RHash67/fbii-xl2t/arduino/README.md

## FBII XL-2T Interface - Arduino sketch

The Keypad_Interface.ino sketch is for the arduino alarm interface/connection as shown in the circuit diagram in this repository.

Serial communication with the Raspberry Pi is very simple.  A 1-byte character is sent from the RPi for an interface request.  ASCII characters 48 through 63 correspond to keypress signals.  ASCII character 64 causes the arduino to retrieve the 2-byte alarm status data packet and send it back to the RPi as a 5-byte string representation of the packet int value (parsing of the data packet to get the individual LED display status is done in the RPi since this only requires 5 bytes of data to be sent serially, rather than 12 bytes).

The libraries for this sketch can be found in the libraries folder in this repository.

The Interface_simulation.ino sketch will allow you to test the Raspberry Pi web interface and arduino serial communication without having to connect the actual alarm system.  The arduino sends preset alarm status values to the RPi, and indicates keypresses via the onboard LED.  The sketch includes a simulated alarm event for 10 seconds - this is useful for testing your email alarm notification.  My family was getting tired of my messing around with the alarm system, and the keypad buzzer constantly sounding during my web interface testing, so I came up with this sketch.
