RHash67/fbii-xl2t/_library/examples/README.md

Example Arduino sketches which uses the XL2T library.
