RHash67/fbii-xl2t/_pics/XL-2T Keypad closed r1.jpg

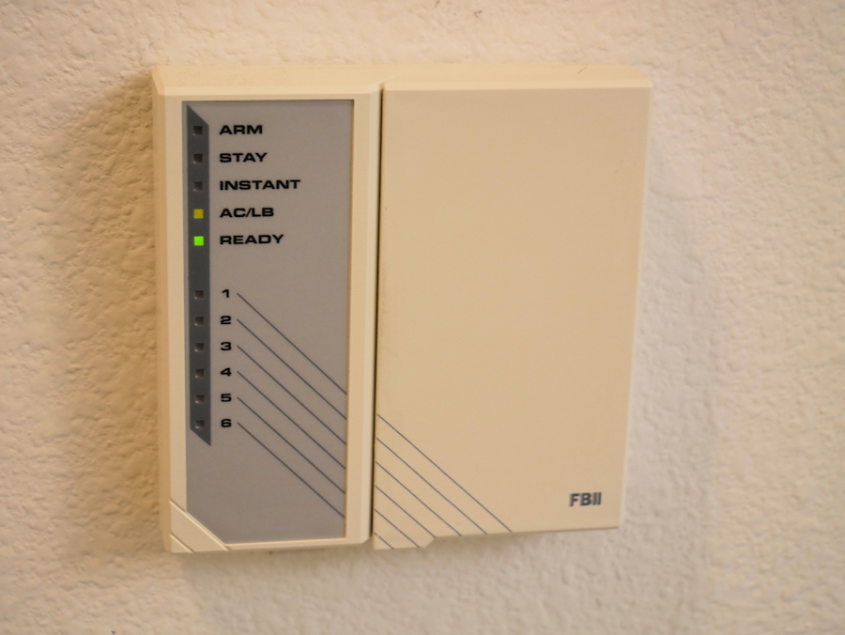
_pics/XL-2T Keypad closed r1.jpg
