RHash67/fbii-xl2t/data_signal_info/Oscope trace unarmed_ready.jpg

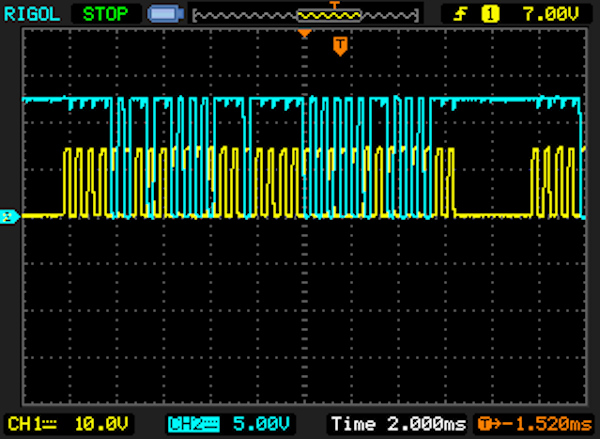
data_signal_info/Oscope trace unarmed_ready.jpg
