RHash67/fbii-xl2t/_testcode/README.md

Arduino test sketches for displaying alarm and keypad data values
