RHash67/fbii-xl2t/(threads)

Thread 3 (2023-07-03):

Driving the keypad from the uC

rooprob, 2023-07-03:
First, thanks for this.  I have a FBII STAR XL4500 and XL4500RM keypad.  My uC is an ESP8266.

The circuit is on a breadboard and I have the 12v reduced to 3.3v for the ESP. Arduino compiled the code, and I've made some small tweaks but it's basically working as-is. Nice!

I can read the status and LEDs with this project, but sendKey is not.
No errors and I see a little signal on Q3.

This is where my understanding breaks down.

How does the signal get put back to the yellow data line from the uC?

I'm trying to work out the purpose of R8.

I don't understand the Shunt. I'm trying to understand how writing to Shunt can put a 12v signal on Data line.

I'm only getting 3.3v out of the

I'll need to get more detailed testing.

Thanks for any pointers!
Good job on the code! I guess there are now two people adding WiFi to their 20yo alarms.

RHash67, 2023-07-07:
The keypress data is sent to the system by controlling the level of the data line during the low clock pulses.  If the shunt control is switched to its low level, then Q3 will be off, and the data line will remain high.  If the shunt control is switched high, then Q3 will turn on, and the data line will be forced to ground level (low).  The keypress signal is not “put onto” the data line – rather, the data line is just kept high or sent low (during the low clock pulses) to “send” the data.

R8 is there mostly for circuit stability.  If the shunt control level is floating for any reason (e.g. during circuit startup, or gets disconnected), R8 will ensure that Q3 is off, so it doesn’t affect the value of the data line during the read portion of the clock signal.

For my system I need to use transistors to interface the clock, data, and shunt because my alarm panel (FBII XL-2T) has the clock and data at +12V - +15V range.  If I try to connect those directly to my uC I will burn it out.  I’m not familiar with your FBII SA4500 system, but if your clock and data signals are at 3.3V levels, then you might be able to monitor/control them via direct connection to your uC without using transistors.  If you do this you will need to modify the code to invert the logic levels, since the transistors invert the logic levels between their base and collector.  In the XL2T_Interface.cpp code, the _pulselvl and _signallvl variables are used to read the logic level of the signals.  If you read the signals directly, then you will need to modify the conditional tests (e.g. instead of testing == 0, would need to test == 1), and possibly modify code sections which invert the bits.

When I started this project I could not determine if the data stream followed any standardized format (e.g. RS-232, etc, which it does not).  Luckily the clock pulse period is rather long (0.5 ms), so I could easily capture the pulses with my digital oscope to reverse-engineer the signals.  Also, the clock pulses are slow enough where the code just relies on looking for the rising/falling edges of the clock, and counting the pulses.  I know this is not very sophisticated, but hey – it works!  😊

Good luck on your system interface!  I'm glad that someone has found this useful!

RHash67, 2023-07-07:
Also, keep in mind that a minimum of 2 identical keypress data needs to be sent in adjacent data packets to be considered a valid keypress.  The arduino code handles this via a simple loop for the keypress routine.

rooprob, 2023-07-24:
Thanks @RHash67

Thanks for your reply.   I can see how the shunt circuit works now, and I'm pleased to say it's all working well for me now.

Turns out the XL2T and the SA4500 are pretty much the same electrically and signalling. I get pretty much identical Alarm Status codes as you do.  My keypad does have different keycodes, and following your idea they are scattered around in the uint32_t as an obscurity, I have now successfully decoded, and I can send them back into the alarm to Arm it.

I had to make a few adjustments on this journey.
* read the keycode along with the alarm status during the readAllStatus()
* add the helper functions to read the alarm status bits from status value, rather than re-probing for them
* added a microsecond sleeps to try and put the bit-reading code directly in the middle of the 250us clock signal - the issue I had was I was reading the trailing edge and getting a lot of  jitter - maybe my Arduino is a bit faster or my wiring a bit noisy.

This clunky old alarm gets a useful IoT modernization. It will be taking up residence in the workshed.

Can consider this issue closed :)

RHash67, 2023-07-25:
Glad you were able to get your interface working!

It didn't occur to me that different FBII systems could have different keycode values.  Somewhere in my files I have a test sketch to display the keycode hex values on an LCD screen hooked up to the arduino - I should post them here (hopefully I've kept it somewhere).  I forgot I had used this as a "digital oscope" to capture the signal values.  I do have a "real" oscope, but it's not sophisticated enough to record waveforms on trigger events.  The test sketch I made was very handy in displaying the hex values associated with each keypress.

I'm happy to see at least one other clunky old alarm meeting the modern world!  :D

Closed 2023-07-24.

Thread 4 (2025-05-01):

gunicorn is not starting

stavreas, 2025-05-01:
× gunicorn.service - gunicorn daemon for /var/www/html/XL2T.py
     Loaded: loaded (/etc/systemd/system/gunicorn.service; enabled; preset: enabled)
     Active: failed (Result: exit-code) since Thu 2025-05-01 16:54:48 BST; 7s ago
   Duration: 47ms
    Process: 8532 ExecStart=/usr/local/bin/gunicorn --bind=unix:/tmp/gunicorn.sock -k geventwebsocket.gunicorn.workers.GeventWebSocketWorker --workers=1 XL2T:app (code=exited, status=203/EXEC)
   Main PID: 8532 (code=exited, status=203/EXEC)
        CPU: 12ms

May 01 16:54:48 raspberry-FBII systemd[1]: Started gunicorn.service - gunicorn daemon for /var/www/html/XL2T.py.
May 01 16:54:48 raspberry-FBII (gunicorn)[8532]: gunicorn.service: Failed to locate executable /usr/local/bin/gunicorn: No such file or directory
May 01 16:54:48 raspberry-FBII (gunicorn)[8532]: gunicorn.service: Failed at step EXEC spawning /usr/local/bin/gunicorn: No such file or directory
May 01 16:54:48 raspberry-FBII systemd[1]: gunicorn.service: Main process exited, code=exited, status=203/EXEC
May 01 16:54:48 raspberry-FBII systemd[1]: gunicorn.service: Failed with result 'exit-code'.

I have followed everything on the guide but i faced this issue two times.

Can you help me in order to find out what is wrong?

Also the web-server folder where it should be created? i have put it on /home/username path

RHash67, 2025-05-03:
I'm not sure why you're having problems with the gunicorn service.  Maybe it's a user authentication issue?  When I set up my system, I made a separate sudo user/password (I didn't use the default (at the time) pi username).  Maybe try setting up with your own username if you haven't tried that already?

For my system the web-server folder is actually /var/www/html.  The "static" subfolder, "templates" subfolder and XL2T.py file is in this directory.

stavreas, 2025-05-03:
Thank you for your reply , i appreciate that.

I have manage to solve the issue by creating a symbolic link for the /usr/local/bin/gunicorn to /usr/bin/gunicorn that is actually the directory in my case that gunicorn created it.

That was the issue for the service not starting although i have created another user instead for default "pi" and i have modified the appropriate .conf files with that user.

As for the "static" subfolder, "templates" subfolder and XL2T.py i have put them in the directory that you said (/var/www/html) but as per the instructions i understand that i must put them also in another location that's why i asked for.

Everything is working as per the Pi Zero section , i didnt have the time to flash the arduino and make the physical connections yet , but i will do that soon.

I will report if i stuck somewhere but i think is straight forward.

I would like to thank you for your effort about this project.

stavreas, 2025-05-04:
Ok , i just tried to flash the keypad.ino on my arduino nano v3 (ch340) china clone and i get the following error at compilingA :

"C:\Users\xxxxxxxx\Downloads\Programs\Various\Arduino Projects\FBII Alarm Panel Network Control\fbii-xl2t-master\arduino\Keypad_interface\XL2T_Interface.cpp: In member function 'uint32_t XL2T_Interface::readAllStatus()':
C:\Users\xxxxxxxx\Downloads\Programs\Various\Arduino Projects\FBII Alarm Panel Network Control\fbii-xl2t-master\arduino\Keypad_interface\XL2T_Interface.cpp:104:7: error: '_bitadd' was not declared in this scope
       _bitadd = 0x80000000;
       ^~~~~~~
C:\Users\xxxxxxxx\Downloads\Programs\Various\Arduino Projects\FBII Alarm Panel Network Control\fbii-xl2t-master\arduino\Keypad_interface\XL2T_Interface.cpp:107:7: error: '_bitadd' was not declared in this scope
       _bitadd = 0;
       ^~~~~~~
C:\Users\xxxxxxxx\Downloads\Programs\Various\Arduino Projects\FBII Alarm Panel Network Control\fbii-xl2t-master\arduino\Keypad_interface\XL2T_Interface.cpp:110:33: error: '_bitadd' was not declared in this scope
     _datapacket = _datapacket + _bitadd;
                                 ^~~~~~~
exit status 1

Compilation error: '_bitadd' was not declared in this scope"

Am i doing something wrong?

stavreas, 2025-05-05:
Good morning ,

I have found that in the "XL2T_Interface.h" at private variables it was missing th "uint32_t _bitadd;".

I include this variable and i was able to compile the Keypad.ino without errors.

Is this right? Should i proceed with this action or is was supposed to work as is without this intervention?

RHash67, 2025-05-06:
Have you copied the XL2T_Interface folder into your Arduino/libraries directory?  If not you should do so.  The compiler expects to find the library functions in that directory.

The test sketches for the arduino are intended to operate with the alarm system connected to the arduino.  The main purpose of the sketches is to test the output/interface of the alarm with the arduino before connecting the RPi to the arduino.

If you have the RPi working correctly, the "Interface_simulation.ino" sketch is intended for the arduino to simulate the alarm system connection without actually having to wire in the alarm system.  Just need to connect the RPi to the arduino.
