RHash67/fbii-xl2t/_circuit/XL2T Interface circuit r2.pdf

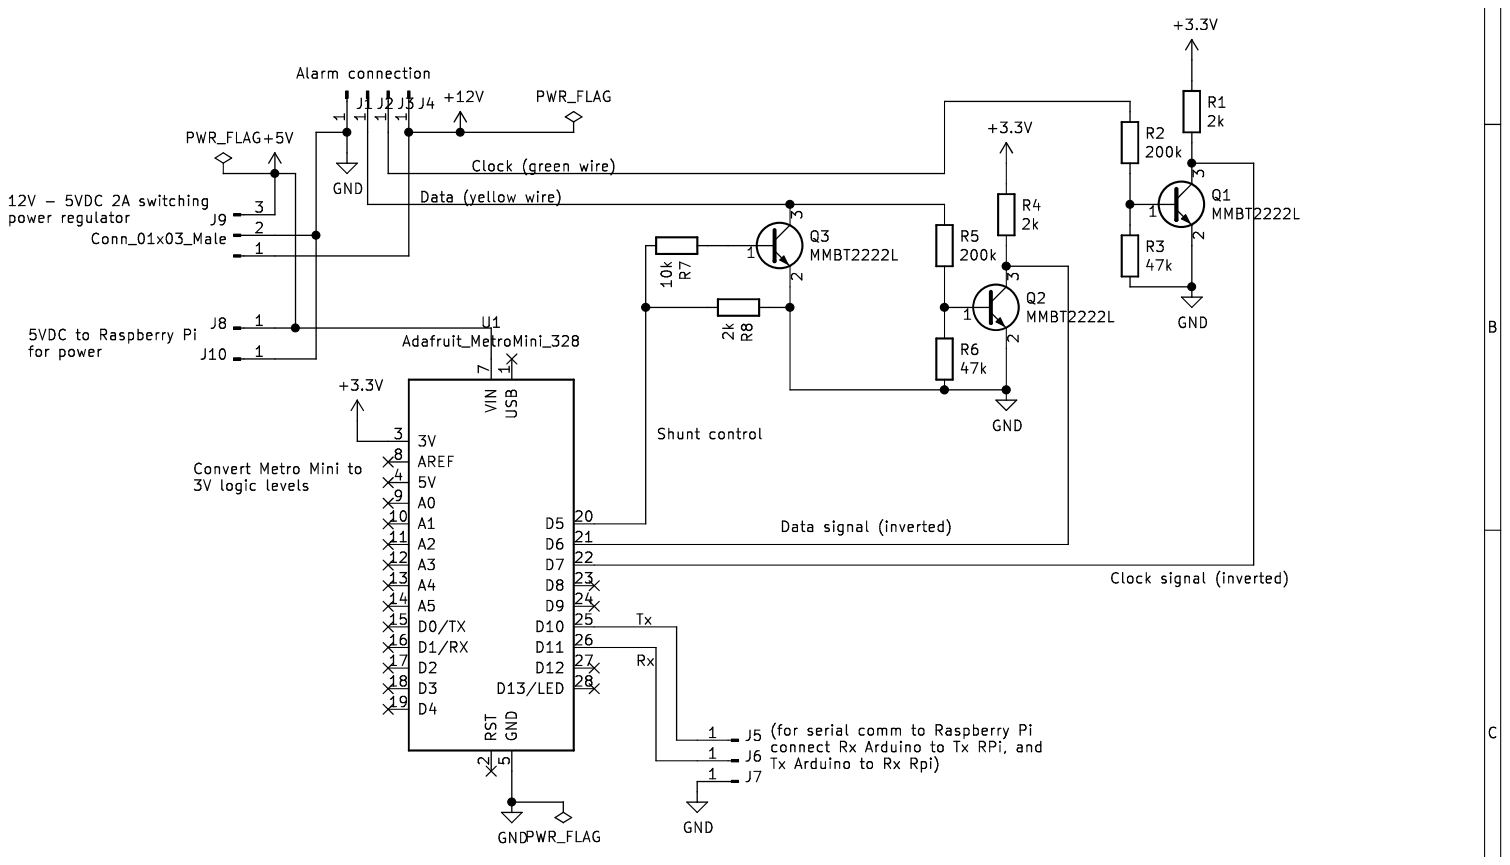
[picture p8: page 1]
