RHash67/fbii-xl2t/data_signal_info/Alarm status values.pdf

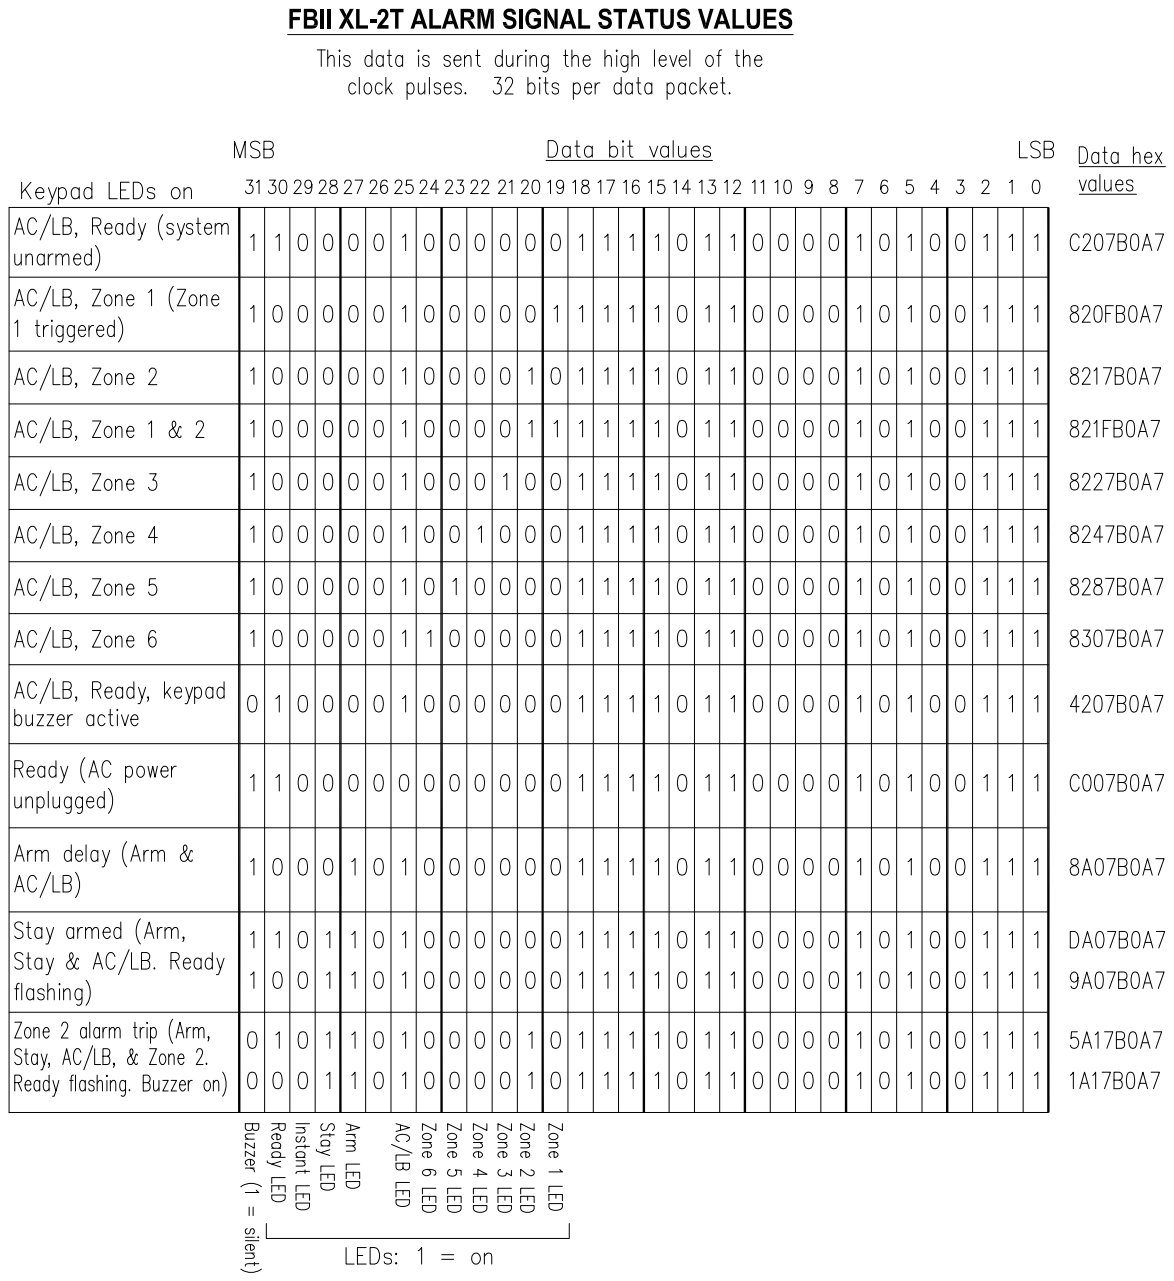
[picture p9: page 1]
