RHash67/fbii-xl2t/data_signal_info/Keypad send values.pdf

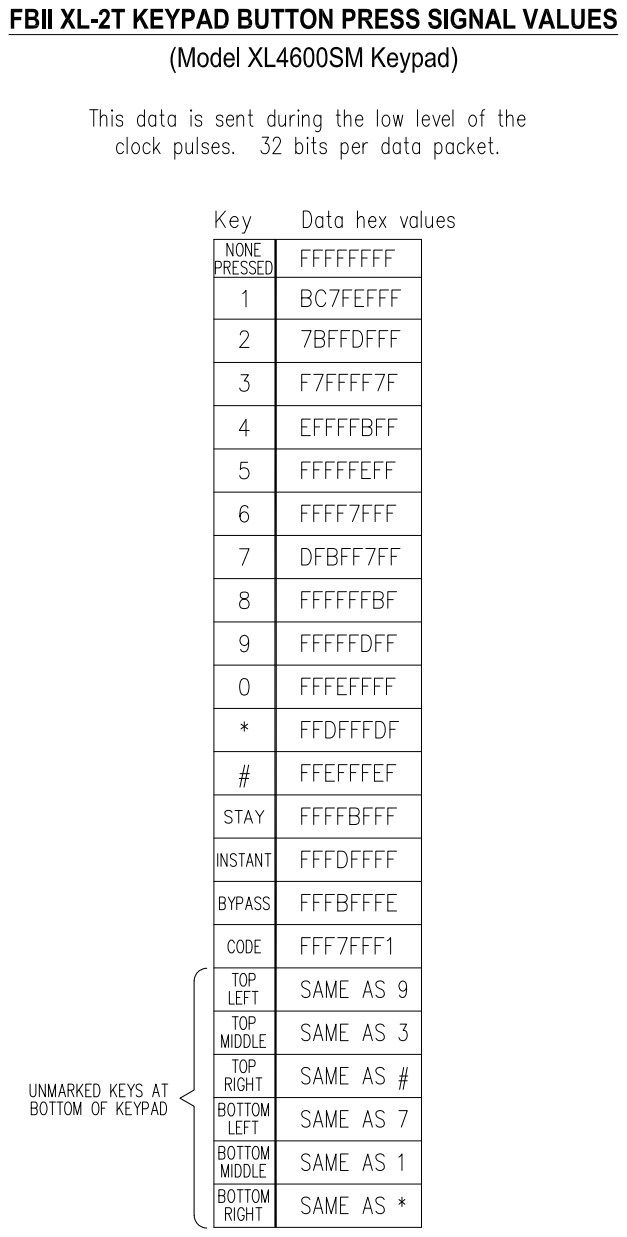
[picture p10: page 1]
