RHash67/fbii-xl2t/data_signal_info/Signal properties.pdf

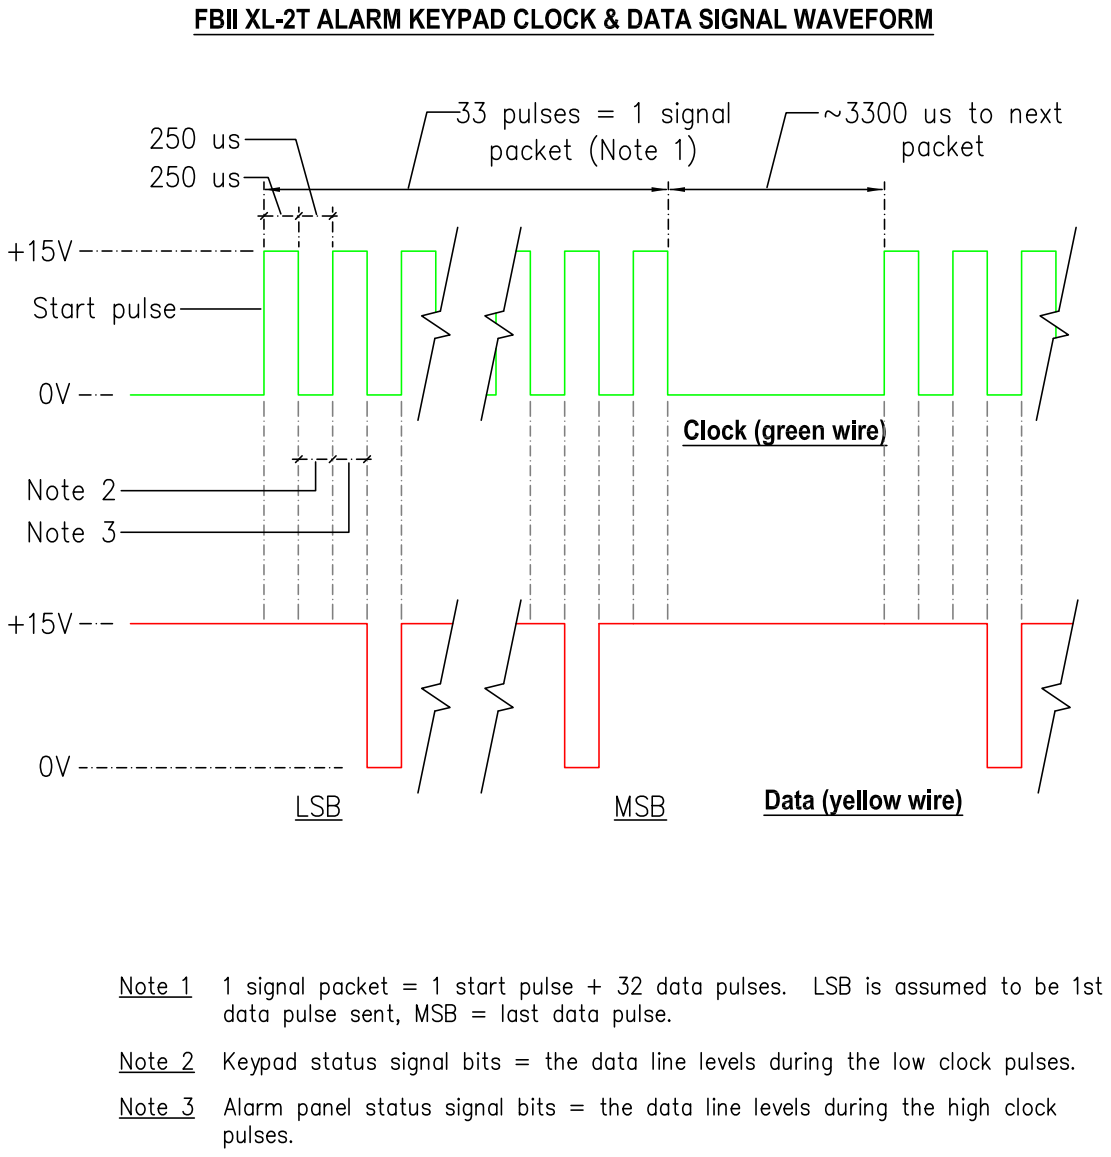
[picture p11: page 1]
