RHash67/fbii-xl2t/(commit log)

2020-06-03 Add files via upload
    Changed the function for the read data packet to load the return variable while the packet is being read (rather than using an array of separate values and then assembling the value after the read). The code is a bit cleaner, and saves a bit on RAM.
2020-06-22 Add files via upload
    Made the following changes:
    1. Header change to refer to Pyhon 3
    2. Reduced the serial port timeout to 0.5 seconds to avoid potential timing overlap problems with the 1-second sleep time between polling the arduino for data.
    3. Added handlers for invalid alarm packet data in case the Arduino is advertently disconnected from the RPi during operation. The default for invalid data is all LEDs and the buzzer off.
    [app.py]
